ing-barbiz/piggysat/Pictures/pic1.jpg

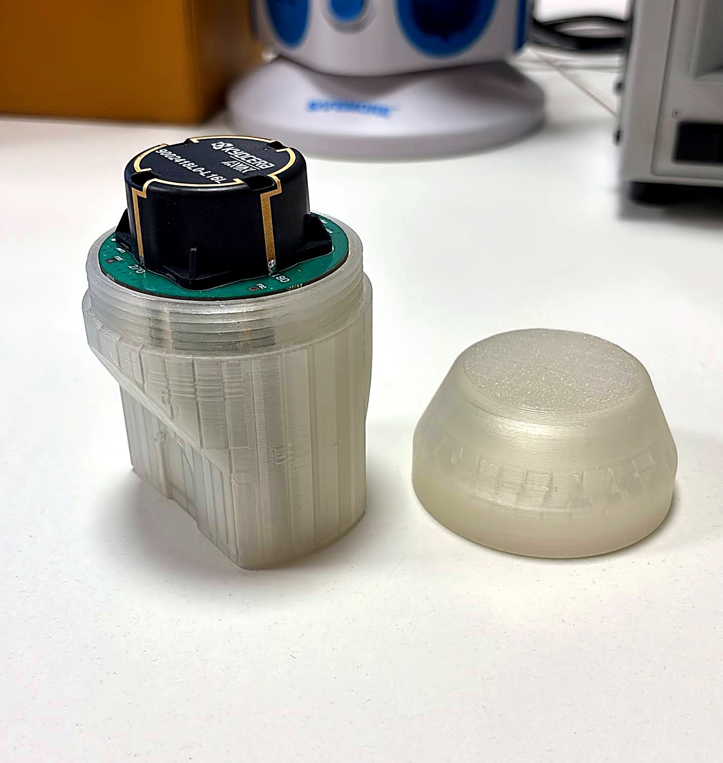
Pictures/pic1.jpg
