ing-barbiz/piggysat/Pictures/pic2.jpg

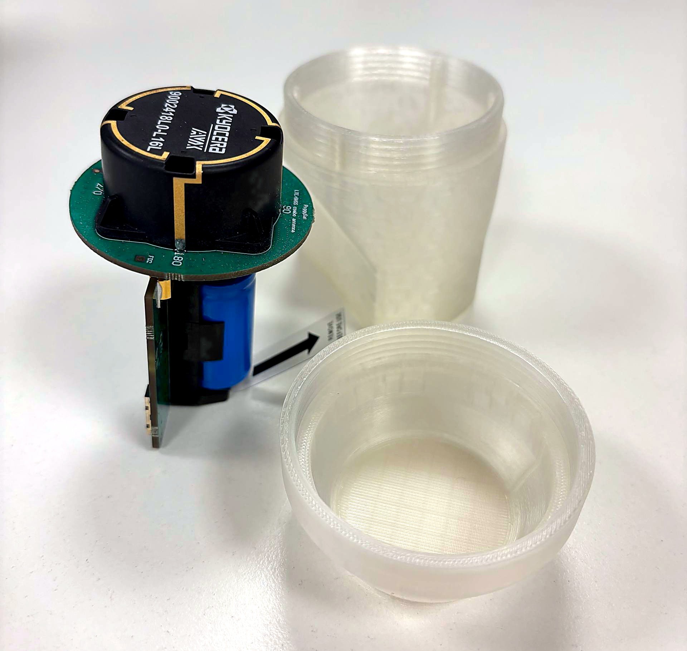
Pictures/pic2.jpg
