ing-barbiz/piggysat/Mechanical/PiggySat_pcb.step

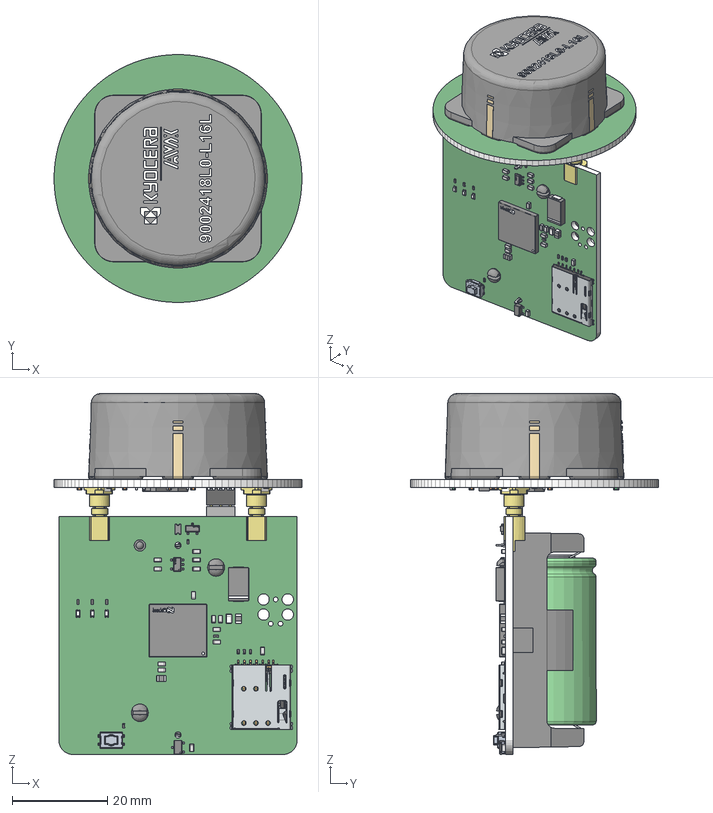
[picture p9: CAD file, 2026-11-08]
Mechanical/PiggySat_pcb.step
52.0 x 52.0 x 75.8 mm
Board x 2
ThermalPin
PinsArrayLR
PinsArrayTB
User Library-res0402-1 x 10
SMM-103-02-SM-S
side x 12
Murata_ x 6
logo x 5
terminals x 5
9002418L0-L16L-PAD_PRINT_LOGO
9002418L0-L16L_PATTERN
WP4G1+
Skyworks
circle
Leads
Murata Logo 3 x 4
User Library-SML-D12 x 3
MRMS201A-001
User Library-Chip Capacitor2 x 14
693041010711_Slider
693041010711_Pin CD
693041010711_Pin long x 3
693041010711_Spring
693041010711_Clip
693041010711_Shielding
693041010711_Pin short x 3
part number & logo
pins
Bourns Logo
ADB1FC9E-4AF8-4470-8ACB-8F955F0B2143
MMT-103-01-SM-SH-TR
Nordic Semiconductor Logo Abjustable
part number
pins.
Electrodes x 2
ECASD40E337M006KA0
SW3dPS-0805 SMD Capacitor
