ing-barbiz/piggysat/Mechanical/PiggySat_housing.step

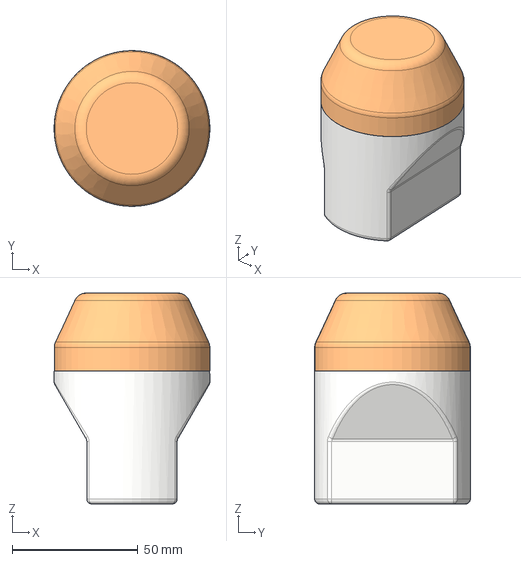
[picture p10: CAD file, 2026-11-08]
Mechanical/PiggySat_housing.step
62.0 x 62.0 x 84.0 mm
