ing-barbiz/piggysat/(list of files, cad)

Other CAD files:
Mechanical/PiggySat_housing.f3z
