ing-barbiz/piggysat/(list of files, drawings)

Other design files:
PiggySat-antenna/PiggySat-antenna.PcbDoc
PiggySat-antenna/PiggySat-antenna.PrjPcb
PiggySat-antenna/PiggySat-antenna.SchDoc
PiggySat-board/PiggySat-board.PcbDoc
PiggySat-board/PiggySat-board.PrjPcb
PiggySat-board/PiggySat-power.SchDoc
PiggySat-board/PiggySat-radio.SchDoc
PiggySat-lib/PiggySat.PcbLib
PiggySat-lib/PiggySat.SchLib
PiggySat-panel/PiggySat-panel.PcbDoc
PiggySat-panel/PiggySat-panel.PrjPcb
