ing-barbiz/piggysat/Measurements/pic1.jpg

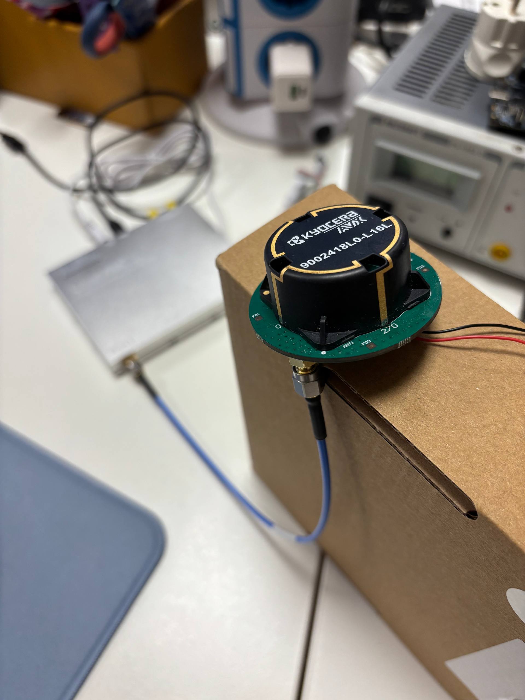
Measurements/pic1.jpg
