ing-barbiz/piggysat/Measurements/pic3.jpg

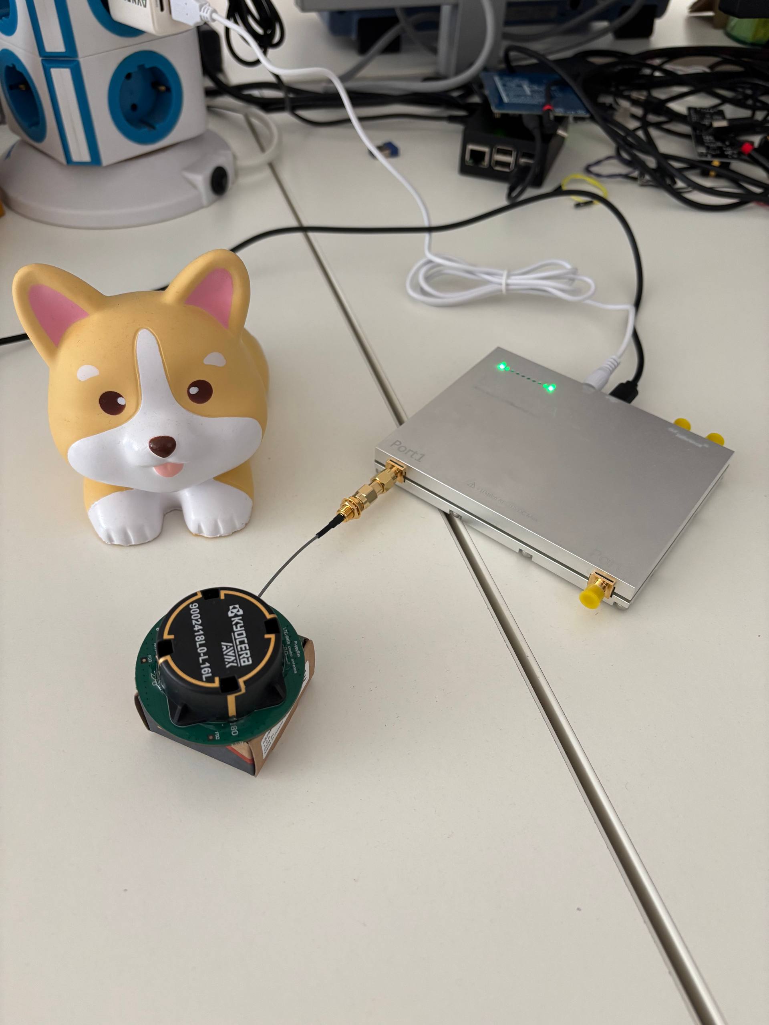
Measurements/pic3.jpg
