ing-barbiz/piggysat/(commit log)

2026-08-15 Initial push
    [Bill of Materials-PiggySat-antenna.xlsx, Bill of Materials-PiggySat-board.xlsx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]
2026-11-08 Stop versioning generated outputs, add measurements and simulations
    - Ignore all "Project Outputs for *" folders and untrack their contents;
    outputs are regenerated from the OutJobs
    - Tidy .gitignore and add Python, editor and Google Drive entries
    - Add VNA S11 measurements and QucsStudio simulations
    - Update README: generated-outputs section, new folders, and fix stale
    stack-up, rules and Ref references
    [Bill of Materials-PiggySat-antenna.xlsx, Bill of Materials-PiggySat-board.xlsx, PiggySat-antenna.step, PiggySat-board.step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]
2026-11-08 Update board, antenna, panel and library design files
    - Update main-board, antenna and panel schematics, layouts and OutJobs
    - Update schematic and PCB libraries
    - Remove housing STEP export (Fusion 360 archive remains)
    [PiggySat-antenna.PcbDoc, PiggySat-antenna.PrjPcb, PiggySat-antenna.SchDoc, PiggySat-board.PcbDoc, PiggySat-board.PrjPcb, PiggySat-panel.PcbDoc, PiggySat-power.SchDoc, PiggySat-radio.SchDoc]
2026-11-08 Align README with repository contents
    Describe only versioned files and folders, drop the housing STEP
    reference and the DRC notes, and document measurements and simulations.
2026-11-08 Add README cover, block diagram and device photos
    - Add comic-style cover artwork and block diagram (SVG) to the README
    - Add device photos, measurement setup photos, and STEP models of the
    housing and PCB assembly
    - Remove vendor datasheets and the third-party material section
    - Update project layout, mechanical and measurement sections
    [PiggySat_housing.step, PiggySat_pcb.step]
2026-11-08 Document S11 measurements with plots and test photos
    - Describe each S11 configuration and mark the final one (2.2 pF + 6.8 nH, cap fitted)
    - Add S11 plots with GNSS L1 and NTN bands and the LibreVNA markers
    - Add worst-case S11 per band and photos of the measurement setup
2026-11-08 Update housing, antenna project and multi-board documents
    [PiggySat-antenna.PrjPcb, PiggySat_housing.f3z]
2026-11-08 Add a picture of the panelized boards to README
2026-11-08 Update main board and panel output jobs and project
    [PiggySat-board.PrjPcb]
2026-11-09 Update changelog limitations and describe PiggySat as an emergency communicator
    - List only the missing display/BLE link and the power consumption to
    improve as known limitations
    - Replace the exported STEP and fabrication outputs, no longer versioned,
    with the output jobs that generate them
    - Call PiggySat a satellite emergency communicator in the README
2026-11-09 New README cover, logo, and consistency fixes
    - Replace the comic cover with the night scene: a piglet in a leather
    aviator cap sends its position to a satellite where there is no coverage
    - Add the logo between the title and the badges
    - Describe the magnet sensor, reset button and LEDs in the README
    - Rename the 8.2 nH measurement files from 8n0 to 8n2
    - Remove the stale third-party sentence from NOTICE
    - Fix README formatting and the Pictures folder description
2026-11-09 Explain the shared LTE/GNSS antenna design in README
2026-11-09 Retouch device photos: white balance, levels, sharpening and crop
2026-11-09 Crop device photos less so the 3D-printed parts stay fully visible
2026-11-09 Show the 3D render next to the device photo in README
2026-11-09 Show device photo and brighter render side by side in a captioned table
2026-11-09 Brighten the PCB in the device photo and restore the original render
2026-11-09 Brighten the PCB green in the other device photos
