ing-barbiz/piggysat/(notices)

Notices in the files:
README.md:
License: CERN-OHL-P-2.0
